Jacob-Lundstrom/lcr-meter-hardware/REV A Input Buffer Mod Board/production/bom.csv

Designator | Footprint | Quantity | Value | LCSC Part #
U1, U2 | DIP-8_W7.62mm | 2 | AMP03GPZ
U3 | DIP-8_W7.62mm | 1 | LF353N
