Jacob-Lundstrom/lcr-meter-hardware/lcr-meter/additional components/_Mechanical/c-1337445-10-3-c-3d.stp

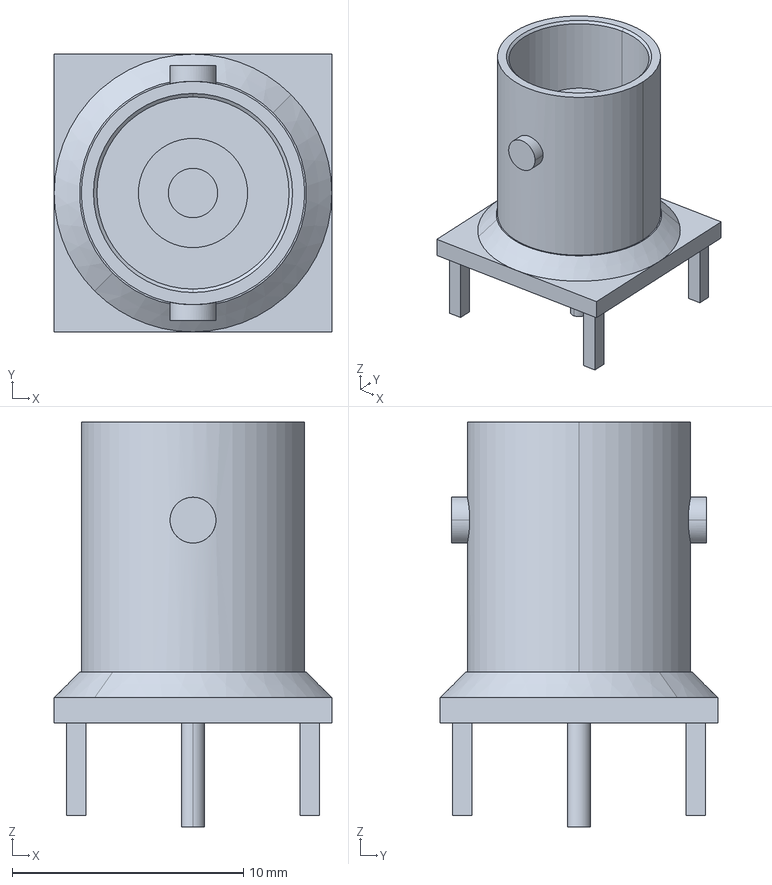
[picture p4: CAD file, 2024-11-07]
lcr-meter/additional components/_Mechanical/c-1337445-10-3-c-3d.stp
12.0 x 12.0 x 17.5 mm
