Jacob-Lundstrom/lcr-meter-hardware/lcr-meter/additional components/CG04874_8M/XTAL_CG04874_NDK.step

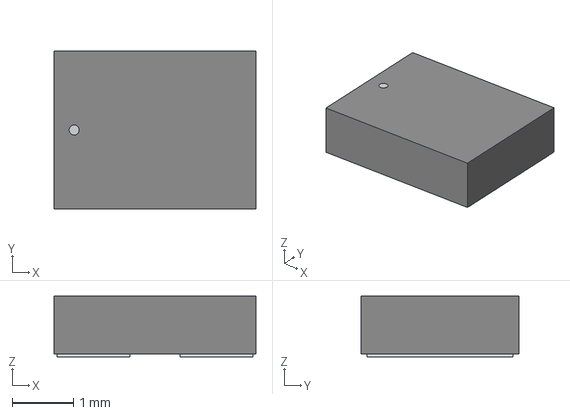
[picture p5: CAD file, 2024-10-27]
lcr-meter/additional components/CG04874_8M/XTAL_CG04874_NDK.step
3.30 x 2.59 x 0.993 mm
