Jacob-Lundstrom/lcr-meter-hardware/lcr-meter/additional components/LF353N_NOPB/LF353N.step

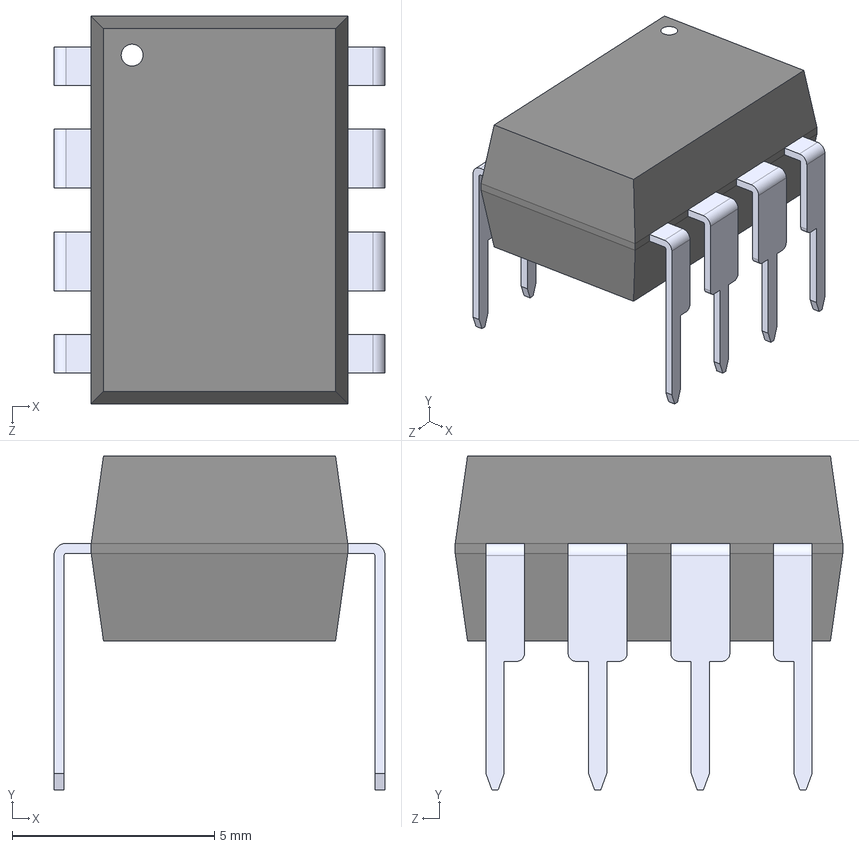
[picture p6: CAD file, 2024-10-28]
lcr-meter/additional components/LF353N_NOPB/LF353N.step
8.19 x 8.26 x 9.59 mm
