Jacob-Lundstrom/lcr-meter-hardware/lcr-meter/additional components/PA4340_332ANLT/IND_223NLT_PUL.step

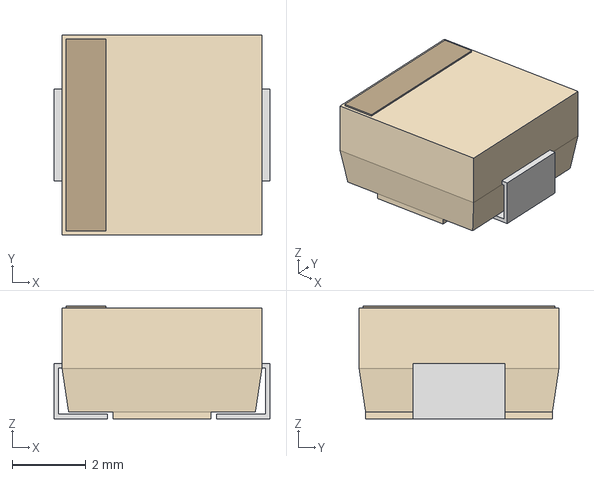
[picture p7: CAD file, 2024-10-27]
lcr-meter/additional components/PA4340_332ANLT/IND_223NLT_PUL.step
5.85 x 5.41 x 3.05 mm
