Jacob-Lundstrom/lcr-meter-hardware/REV A Input Buffer Mod Board/additional components/AMP03GPZ/N_8_ADI.step

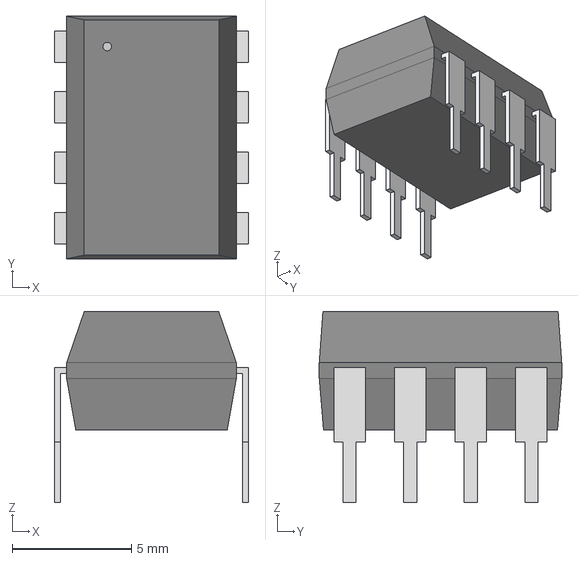
[picture p8: CAD file, 2024-10-13]
REV A Input Buffer Mod Board/additional components/AMP03GPZ/N_8_ADI.step
8.13 x 10.2 x 8.00 mm
