Jacob-Lundstrom/lcr-meter-hardware/lcr-meter/lcr-meter.pdf

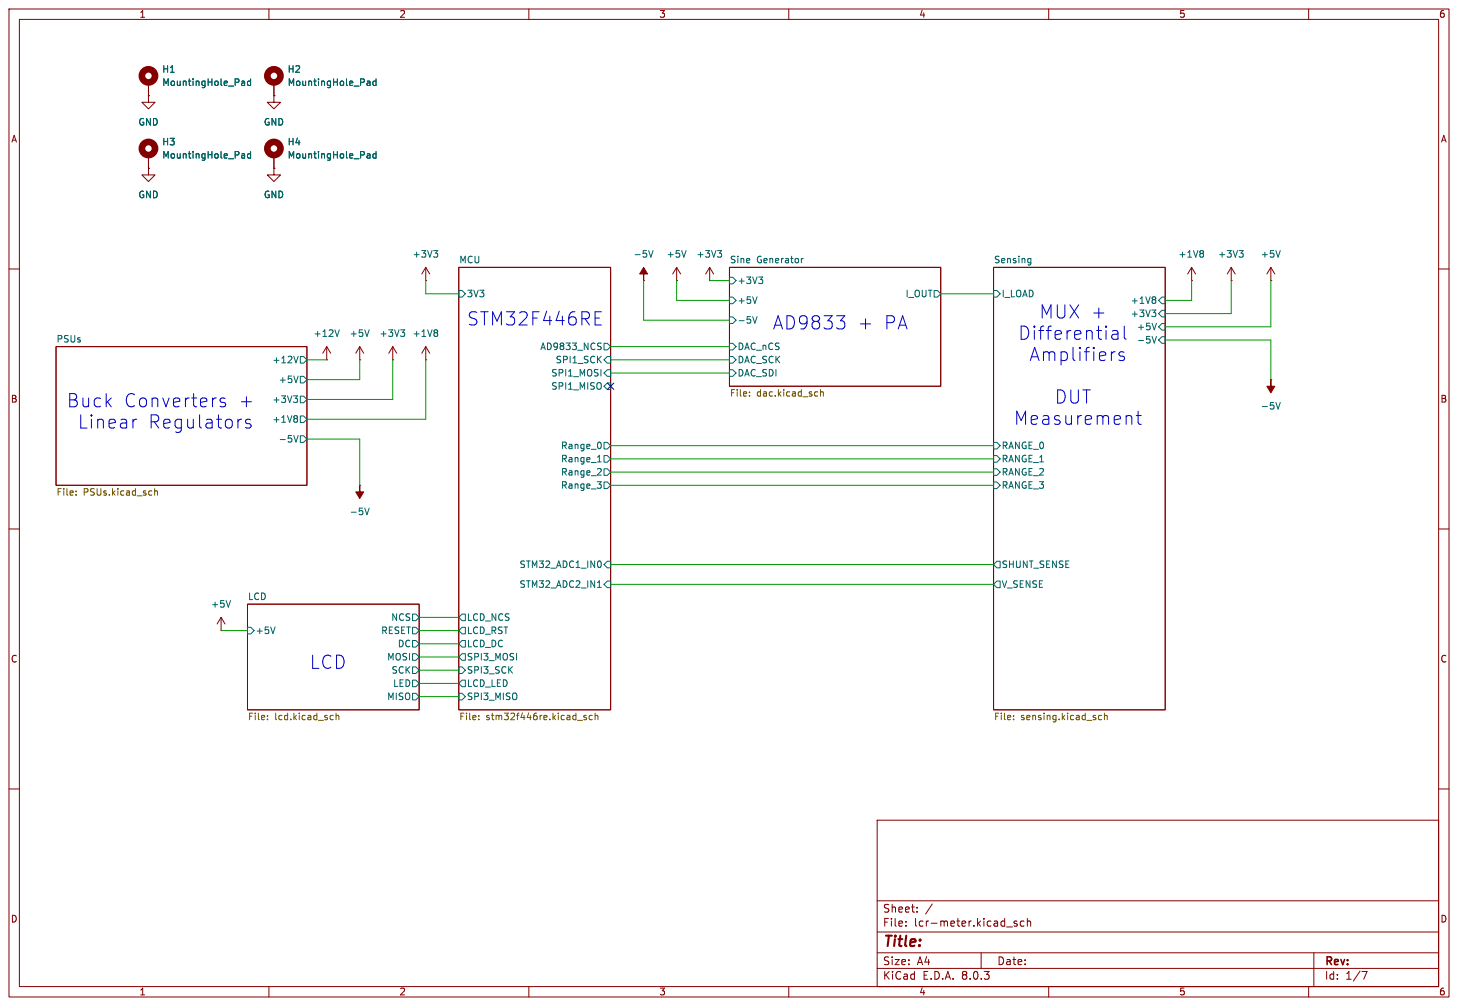
[picture p9: page 1]

NCS
File: stm32f446re.kicad_sch RESET SCK MISO

Id: 1/7 Title: File: lcr-meter.kicad_sch Sheet: /

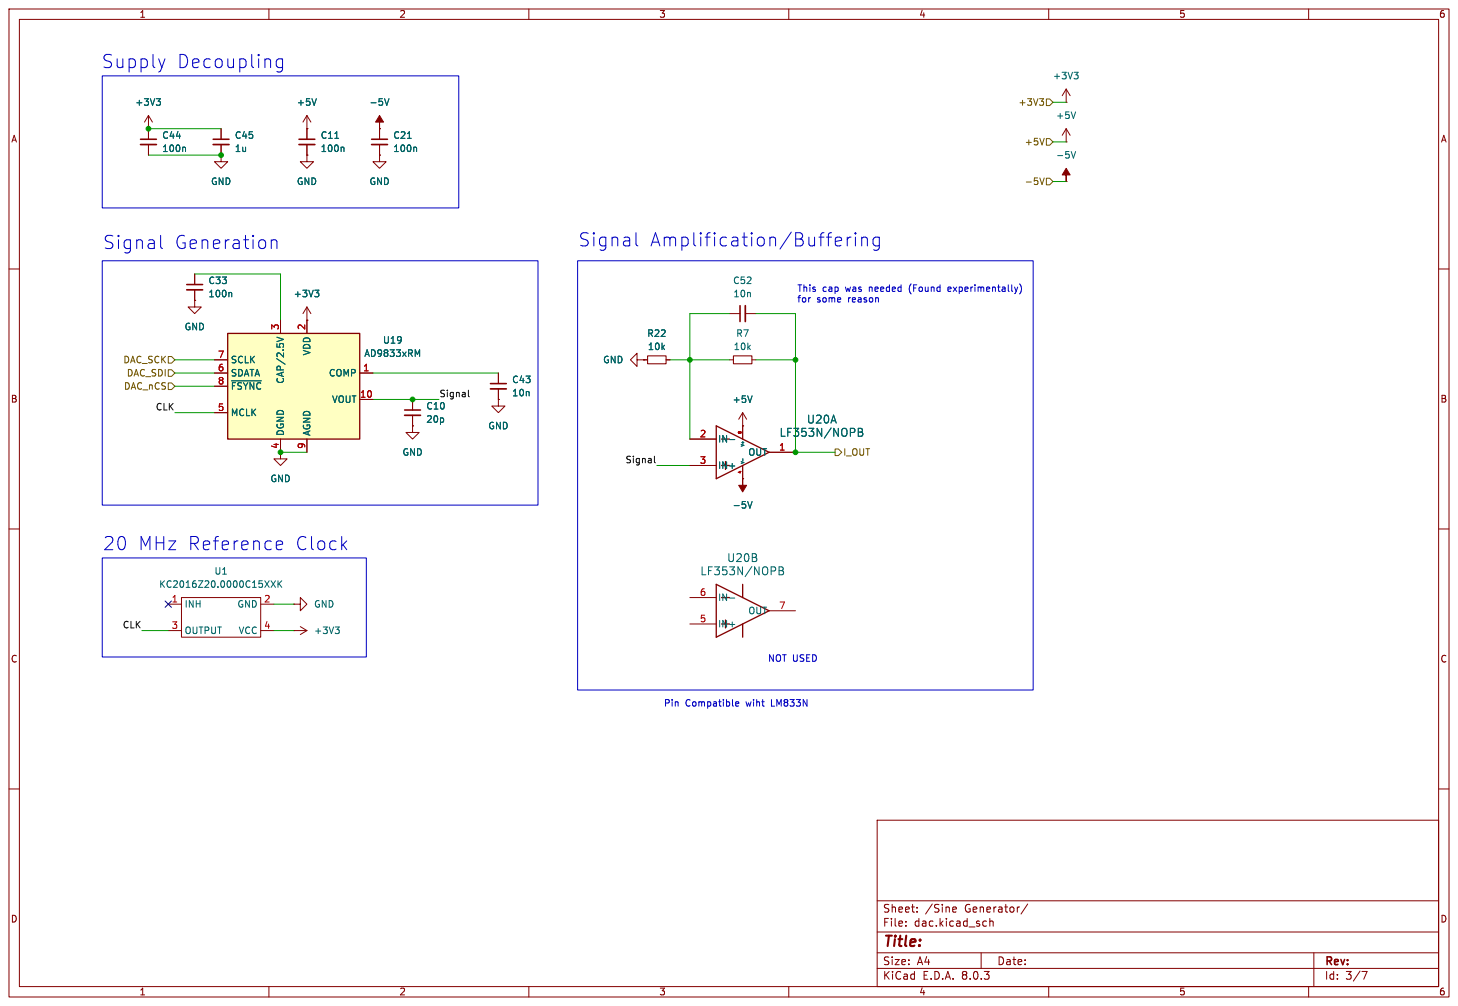
[picture p10: page 2]

This cap was needed (Found experimentally)

4 MCLK 5 SDATA 6 SCLK 7 ~{FSYNC} 8 AGND

Id: 3/7 Title: File: dac.kicad_sch Sheet: /Sine Generator/

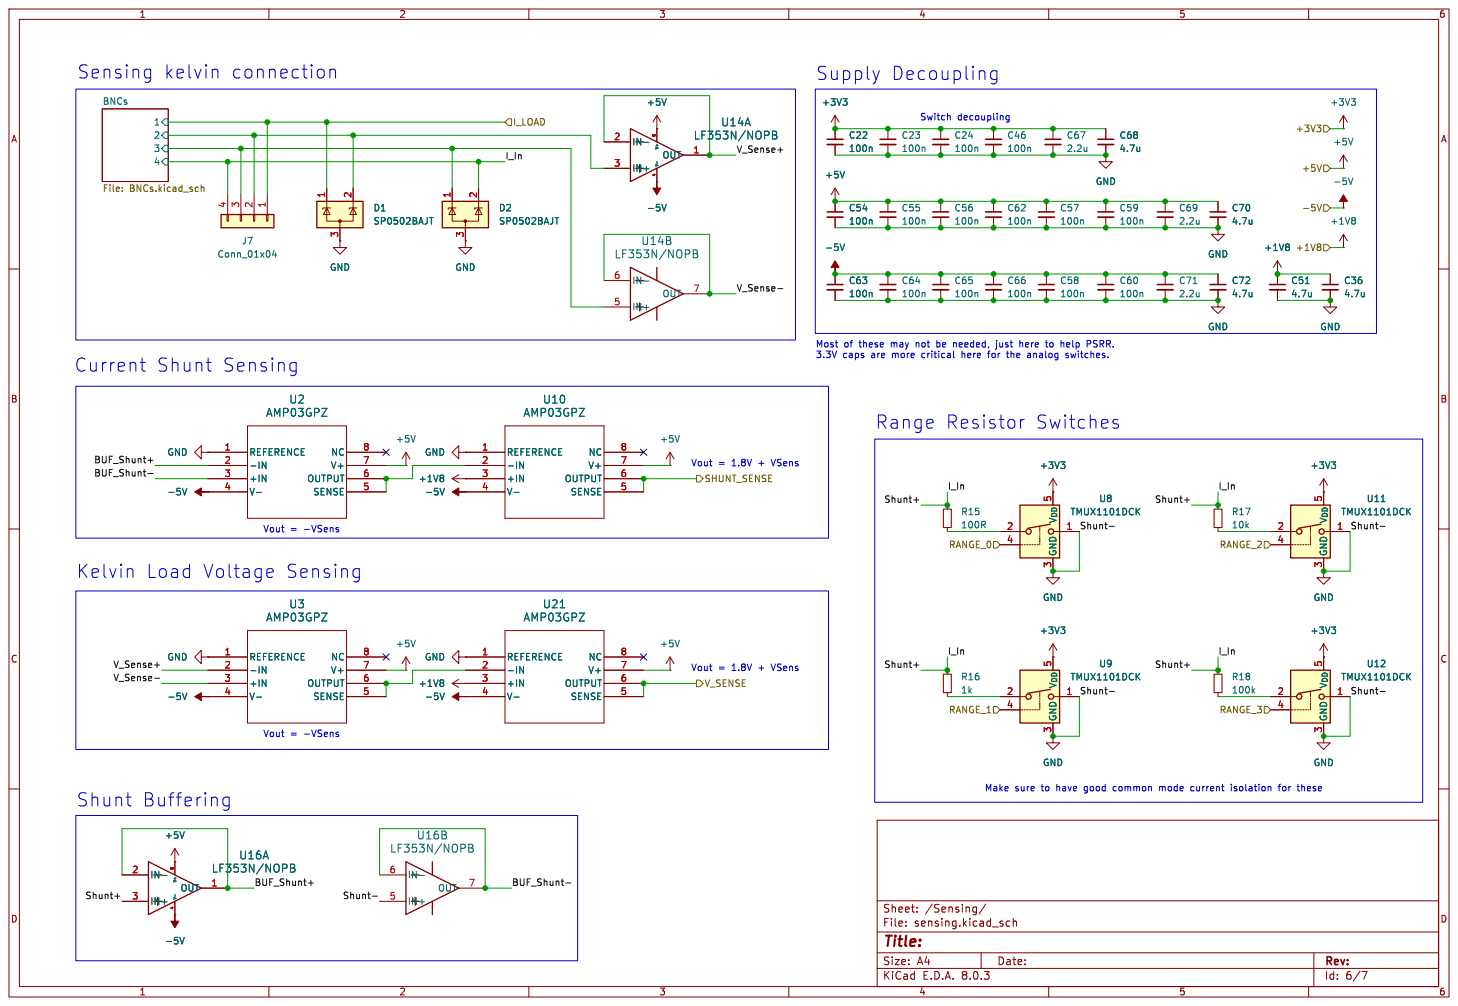
[picture p11: page 3]

Kelvin Load Voltage Sensing

Id: 6/7 Title: File: sensing.kicad_sch Sheet: /Sensing/

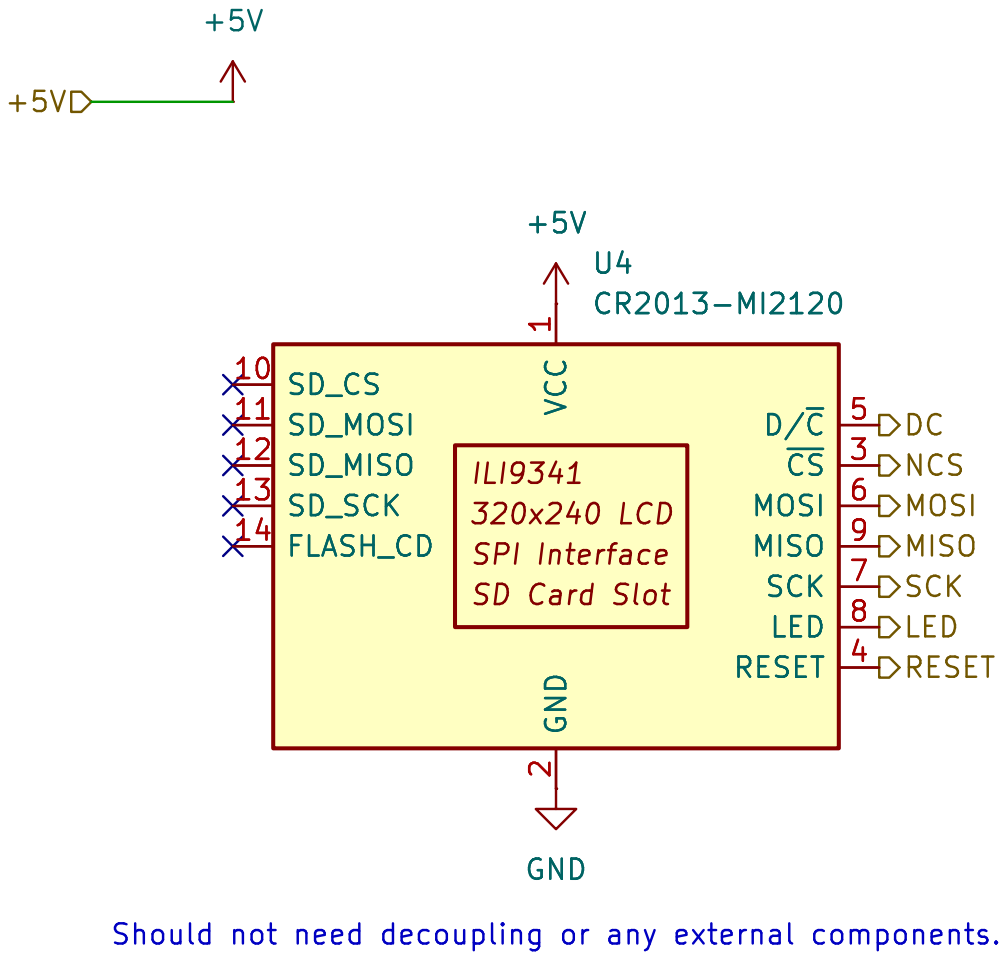
[picture p12: page 4]

ILI9341 SD Card Slot SPI Interface VCC

2 ~{CS}3 RESET 4 D/~{C}5 MOSI 6 SCK 7

Id: 7/7 Title: File: lcd.kicad_sch Sheet: /LCD/

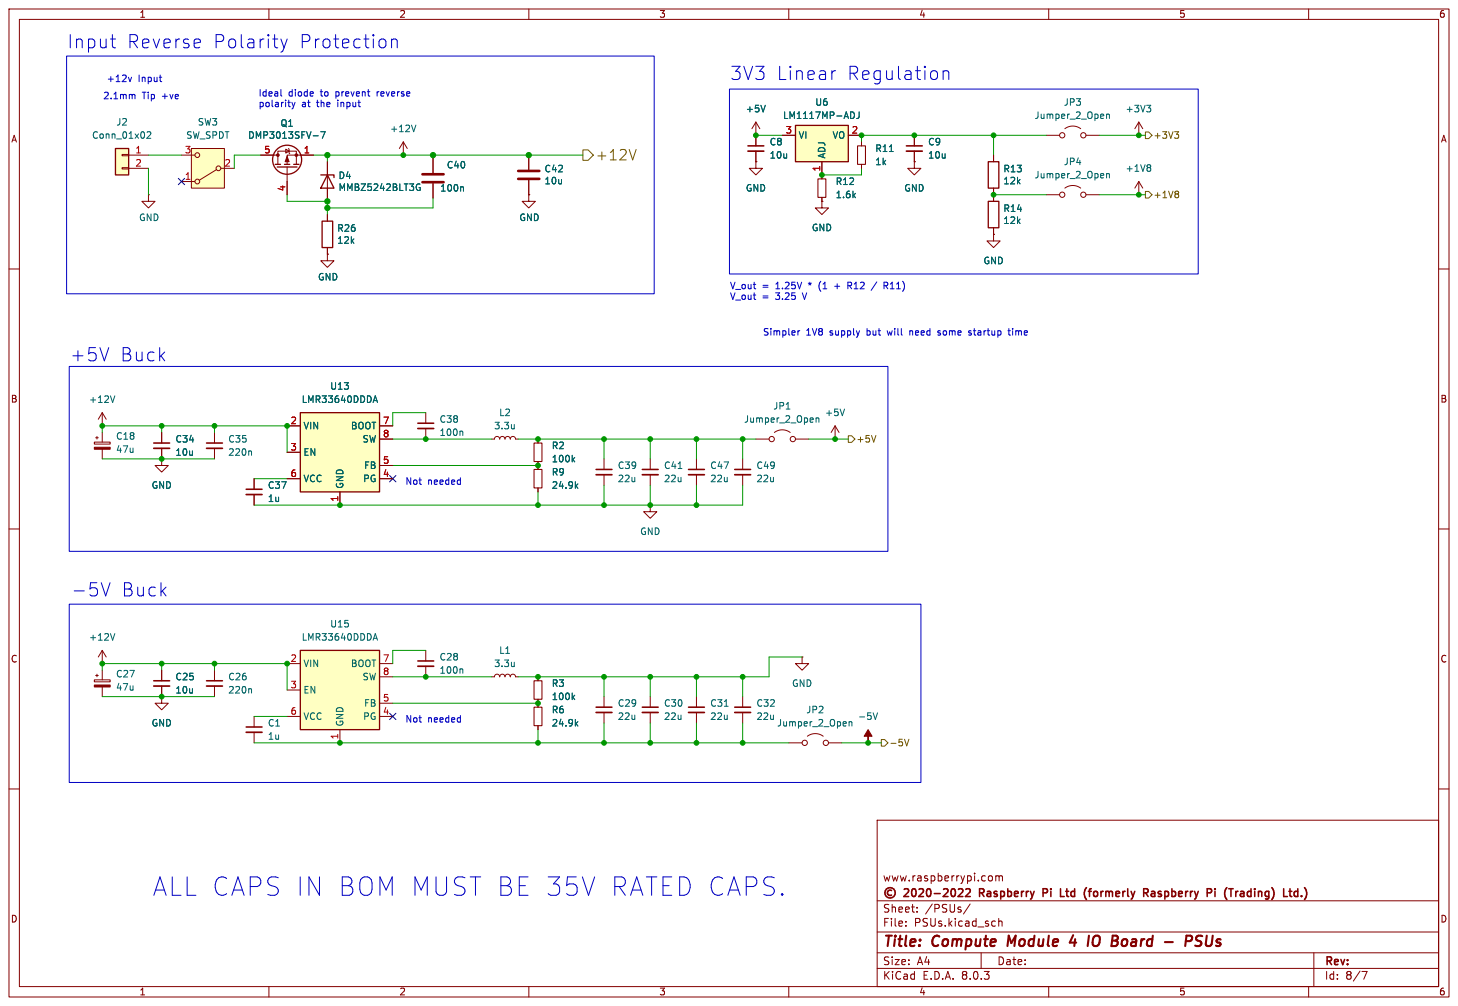
[picture p13: page 5]

2.1mm Tip +ve Input Reverse Polarity Protection

Ideal diode to prevent reverse

Simpler 1V8 supply but will need some startup time

1 VIN 2 EN 3 PG 4 FB 5 VCC 6 BOOT 7 SW 8 U13
LMR33640DDDA

1 VIN 2 EN 3 PG 4 FB 5 VCC 6 BOOT 7 SW 8 R2

Not needed Not needed ALL CAPS IN BOM MUST BE 35V RATED CAPS.
24.9k GND

1 VIN 2 EN 3 PG 4 FB 5 VCC 6 BOOT 7 SW 8 U15

Id: 8/7 Title: Compute Module 4 IO Board - PSUs

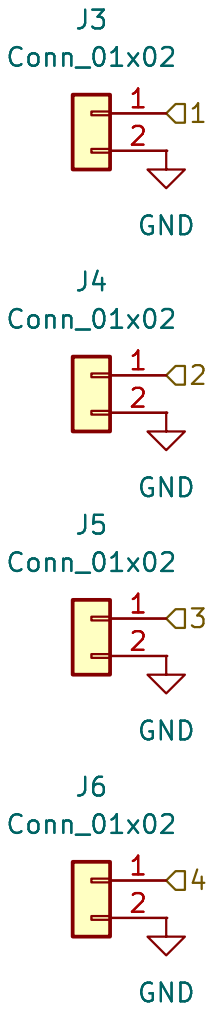
[picture p14: page 6]

Id: 8/7 Title: File: BNCs.kicad_sch Sheet: /Sensing/BNCs/

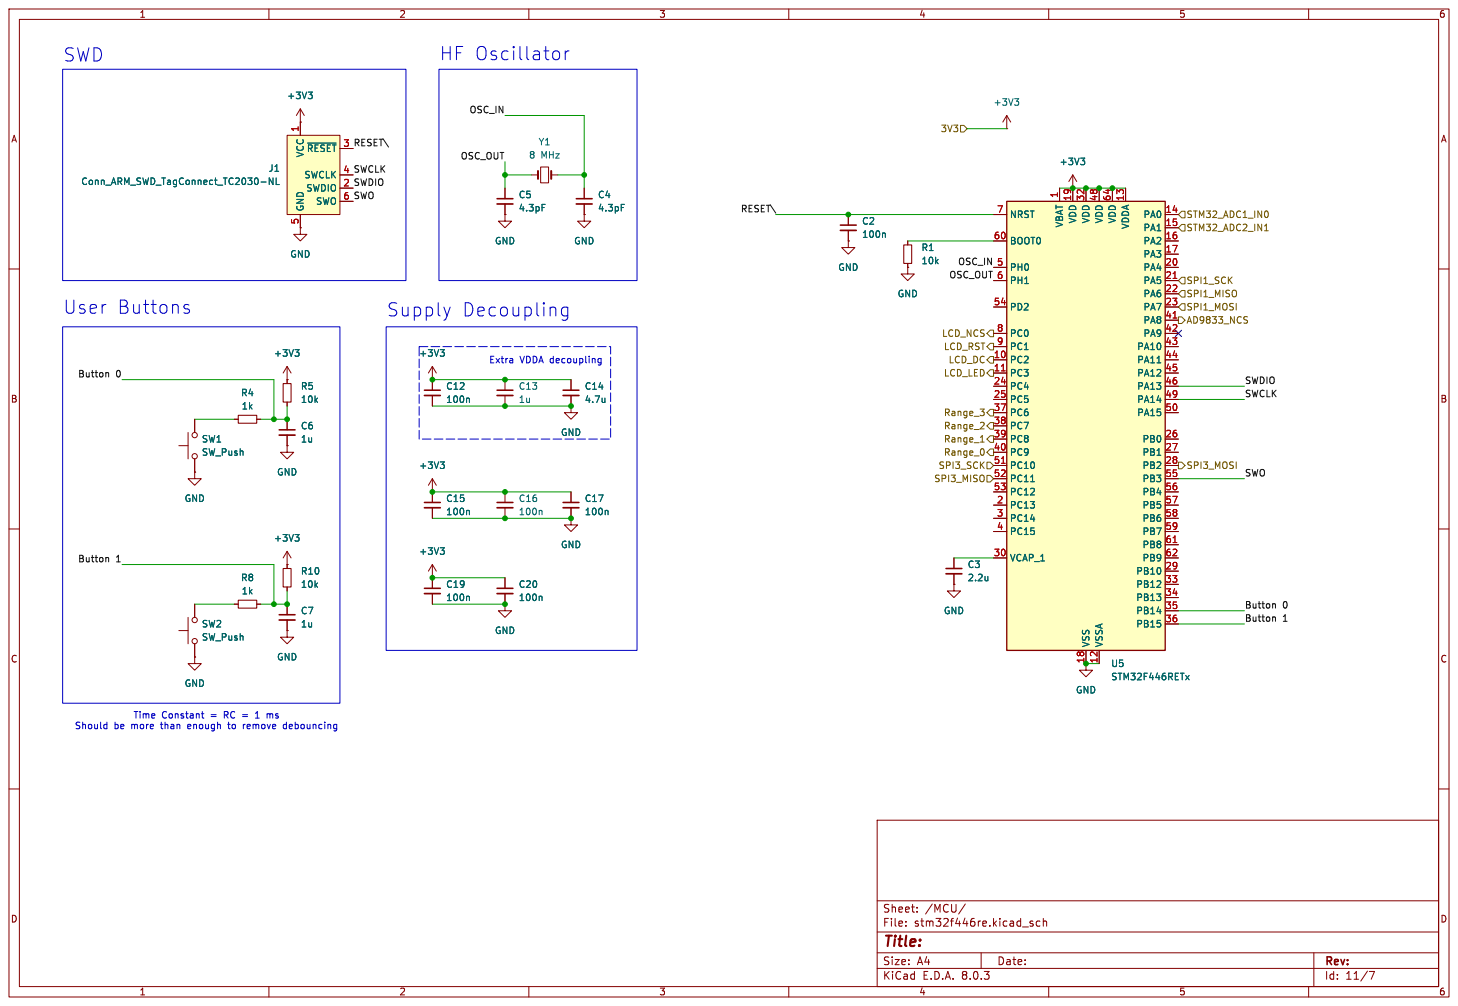
[picture p15: page 7]

1 SWDIO 2 ~{RESET}3 SWCLK 4 GND

1 PC2 10 PC3 11 VSSA 12 VDDA 13 PA0 14 PA1 15 PA2 16 PA3 17 VSS 18 VDD 19 PC13 2 PA4 20 PA5 21 PA6 22 PA7 23 PC4 24 PC5 25 PB0 26 PB1 27 PB2 28 PB10 29 PC14 3 VCAP_1 30 VDD 32 PB12 33 PB13 34 PB14 35 PB15 36 PC6 37 PC7 38 PC8 39 PC15 4 PC9 40 PA8 41 PA9 42 PA10 43 PA11 44 PA12 45 PA13 46 VDD 48 PA14 49 PH0 5 PA15 50 PC10 51 PC11 52 PC12 53 PD2 54 PB3 55 PB4 56 PB5 57 PB6 58 PB7 59 PH1 6 BOOT0 60 PB8 61 PB9 62 VDD 64 NRST 7 PC0 8 PC1 9 U5STM32F446RETx R4

1 PC2 10 PC3 11 VSSA 12 VDDA 13 PA0 14 PA1 15 PA2 16 PA3 17 VSS 18 VDD 19 PC13 2 PA4 20 PA5 21 PA6 22 PA7 23 PC4 24 PC5 25 PB0 26 PB1 27 PB2 28 PB10 29 PC14 3 VCAP_1 30 VDD 32 PB12 33 PB13 34 PB14 35 PB15 36 PC6 37 PC7 38 PC8 39 PC15 4 PC9 40 PA8 41 PA9 42 PA10 43 PA11 44 PA12 45 PA13 46 VDD 48 PA14 49 PH0 5 PA15 50 PC10 51 PC11 52 PC12 53 PD2 54 PB3 55 PB4 56 PB5 57 PB6 58 PB7 59 PH1 6 BOOT0 60 PB8 61 PB9 62 VDD 64 NRST 7 PC0 8 PC1 9 C3

Id: 11/7 Title: File: stm32f446re.kicad_sch Sheet: /MCU/
