Jacob-Lundstrom/lcr-meter-hardware/lcr-meter/lcr-meter.kicad_pcb

## KiCad design lcr-meter/lcr-meter.kicad_pcb (2024-11-10)

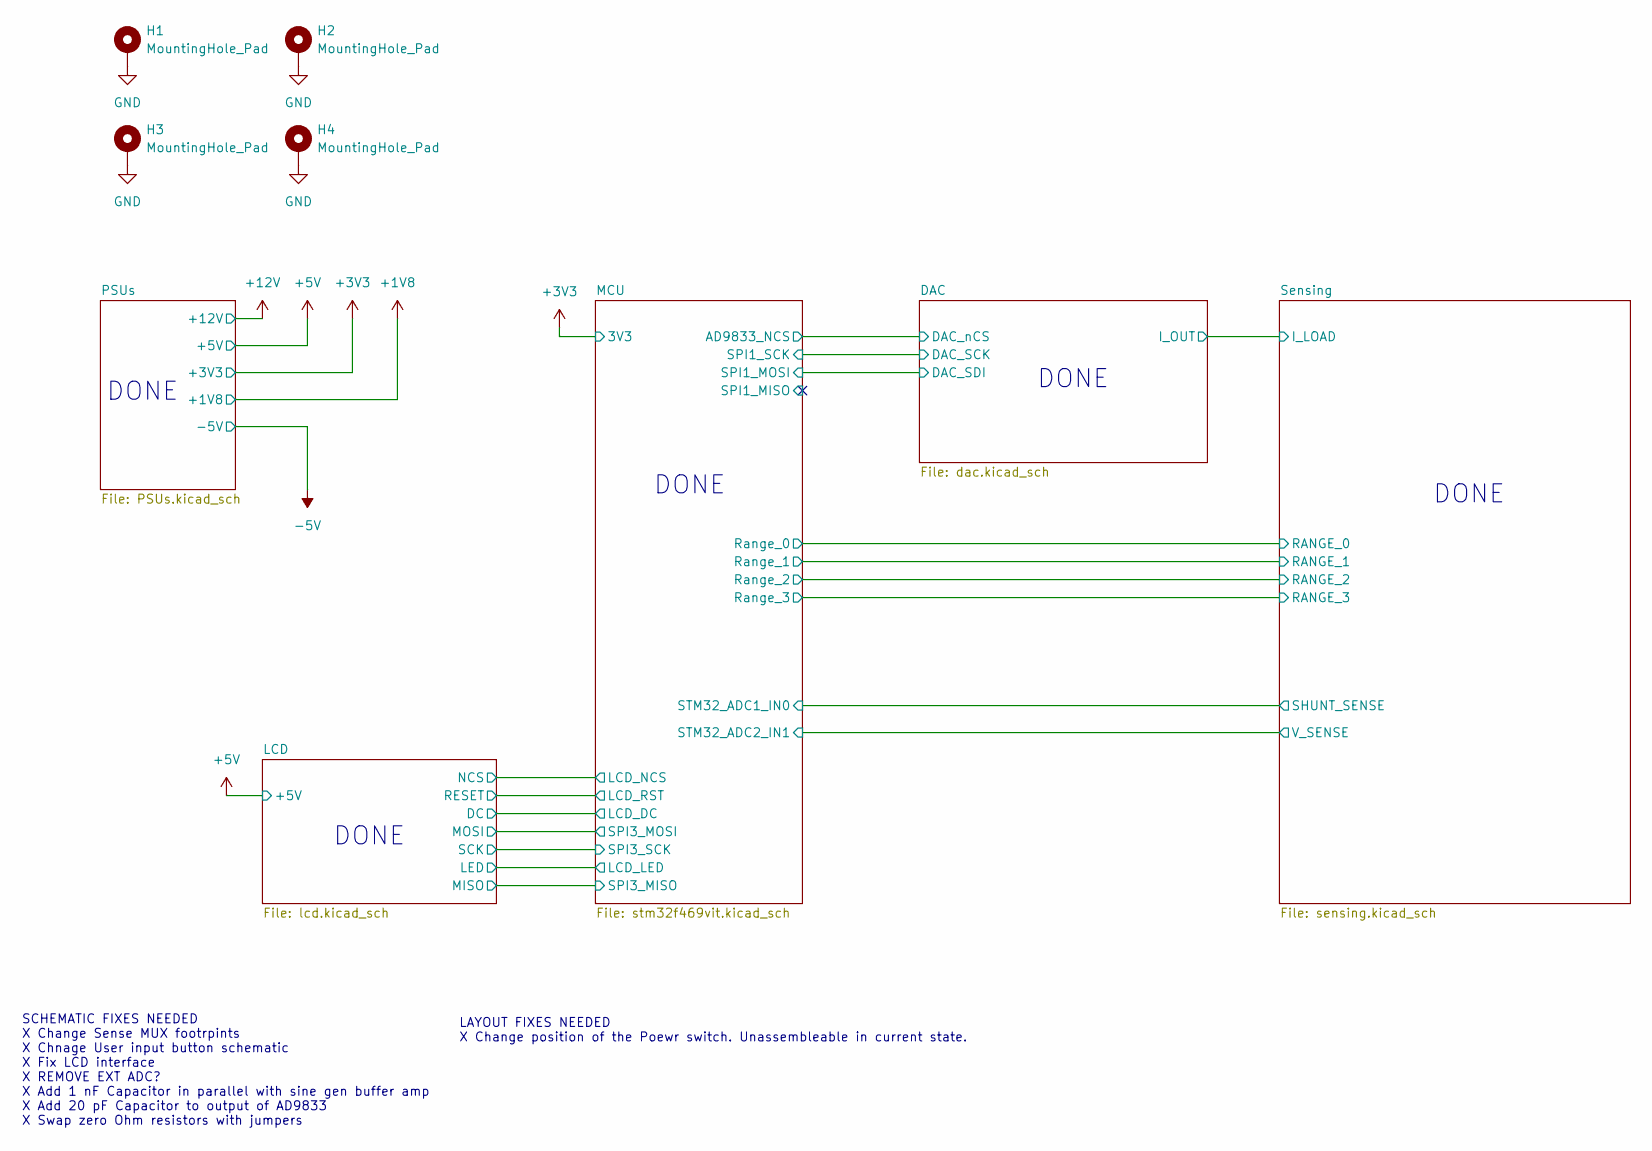
[picture p16: schematic lcr-meter.kicad_sch]

Parts:
H1, H2, H3, H4: MountingHole_Pad; MountingHole_3.2mm_M3_Pad_Via

Connections:
GND: H1.1, H2.1, H3.1, H4.1; also elsewhere on the board

Notes on the sheet:
DONE
SCHEMATIC FIXES NEEDED X Change Sense MUX footrpints X Chnage User input button schematic X Fix LCD interface X REMOVE EXT ADC? X Add 1 nF Capacitor in parallel with sine gen buffer amp X Add 20 pF Capacitor to output of AD9833 X Swap zero Ohm resistors with jumpers
LAYOUT FIXES NEEDED X Change position of the Poewr switch. Unassembleable in current state.

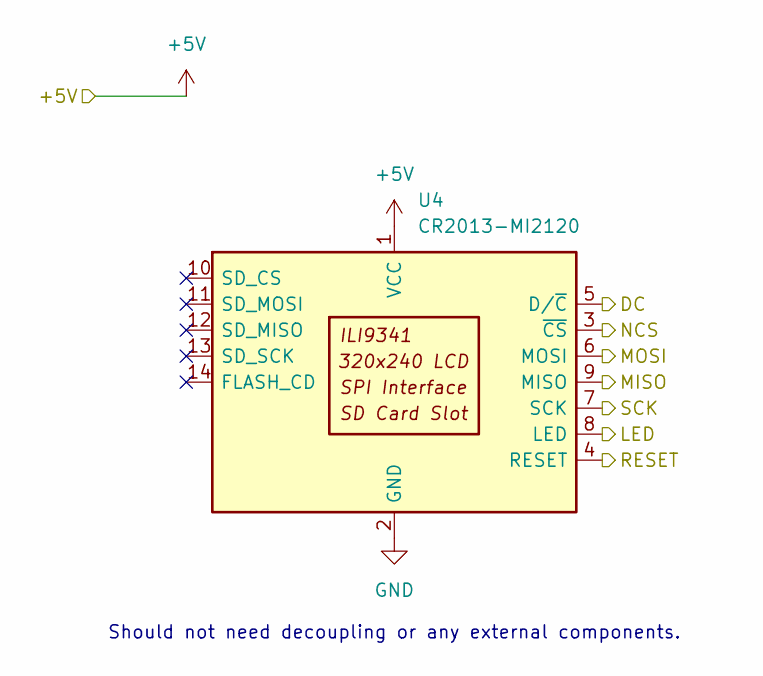
[picture p17: schematic lcd.kicad_sch]

Parts:
U4: CR2013-MI2120

Connections:
+5V: U4.1 (VCC); also elsewhere on the board
/LCD/DC: U4.5 (D/~C); also elsewhere on the board
/LCD/LED: U4.8 (LED); also elsewhere on the board
/LCD/MISO: U4.9 (MISO); also elsewhere on the board
/LCD/MOSI: U4.6 (MOSI); also elsewhere on the board
/LCD/NCS: U4.3 (~CS); also elsewhere on the board
/LCD/RESET: U4.4 (RESET); also elsewhere on the board
/LCD/SCK: U4.7 (SCK); also elsewhere on the board
GND: U4.2 (GND); also elsewhere on the board

Notes on the sheet:
Should not need decoupling or any external components.

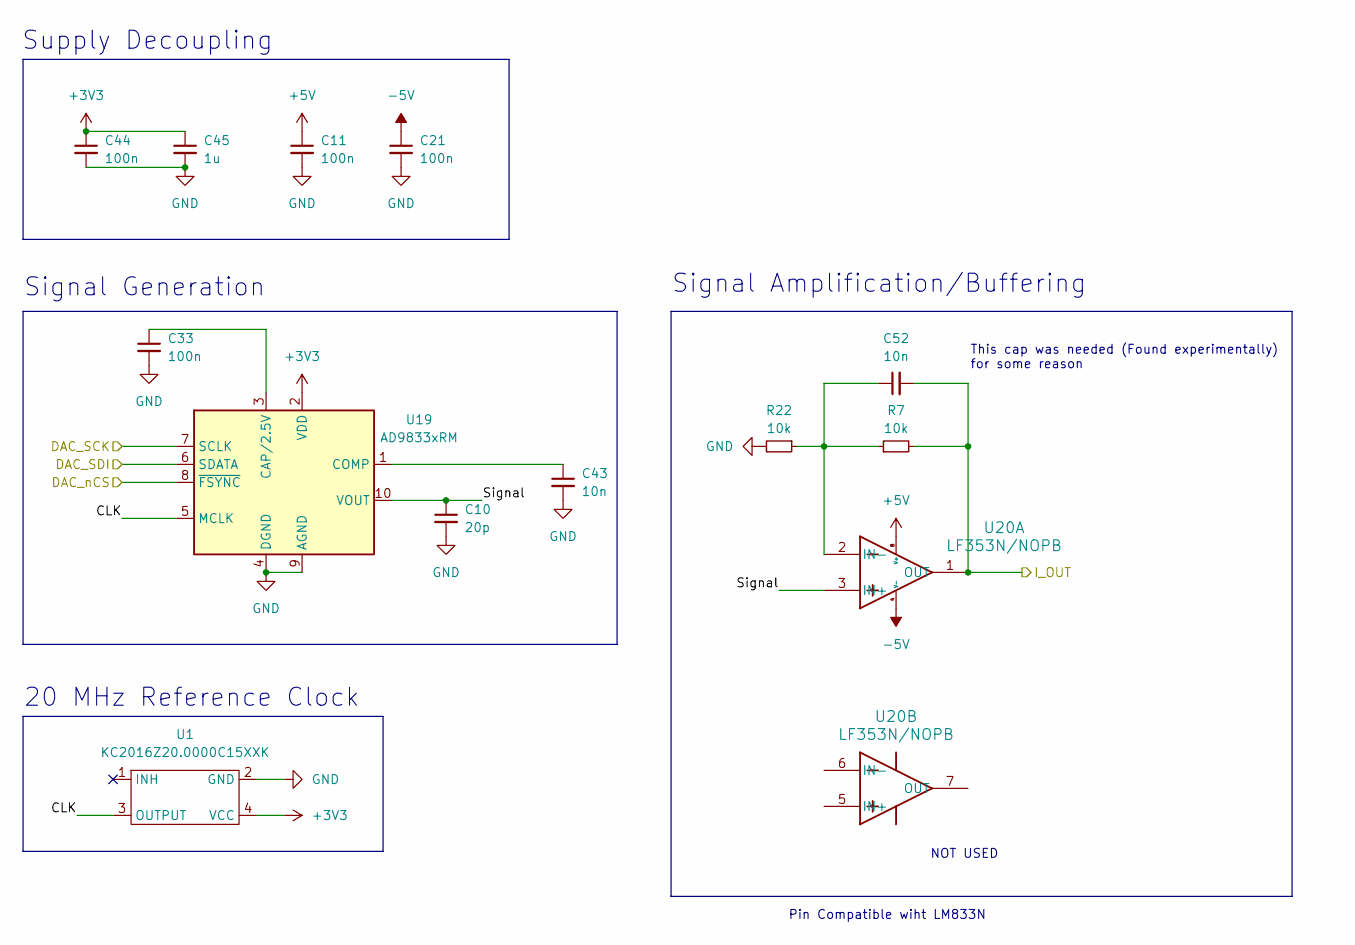
[picture p18: schematic dac.kicad_sch]

Parts:
C10: 20p; C_0402_1005Metric
C11, C21, C33, C44: 100n; C_0402_1005Metric
C43, C52: 10n; C_0402_1005Metric
C45: 1u; C_0402_1005Metric
R7, R22: 10k; R_0402_1005Metric
U1: KC2016Z20.0000C15XXK; Crystal_SMD_2016-4Pin_2.0x1.6mm
U19: AD9833xRM; MSOP-10_3x3mm_P0.5mm
U20: LF353N/NOPB; DIP-8_W7.62mm

Connections:
+3V3: C44.1, C45.1, U1.4 (VCC), U19.2 (VDD); also elsewhere on the board
+5V: C11.1, U20.8 (V+); also elsewhere on the board
-5V: C21.1, U20.4 (V-); also elsewhere on the board
/DAC/CLK: U1.3 (OUTPUT), U19.5 (MCLK)
/DAC/DAC_SCK: U19.7 (SCLK); also elsewhere on the board
/DAC/DAC_SDI: U19.6 (SDATA); also elsewhere on the board
/DAC/DAC_nCS: U19.8 (~FSYNC); also elsewhere on the board
/DAC/I_OUT: C52.2, R7.2, U20.1 (OUT); also elsewhere on the board
/DAC/Signal: C10.1, U19.10 (VOUT), U20.3 (IN+)
GND: C10.2, C11.2, C21.2, C33.2, C43.2, C44.2, C45.2, R22.2, U1.2 (GND), U19.4 (DGND), U19.9 (AGND); also elsewhere on the board
unnamed: C33.1, U19.3 (CAP/2.5V)
unnamed: C43.1, U19.1 (COMP)
unnamed: C52.1, R7.1, R22.1, U20.2 (IN-)

Notes on the sheet:
Pin Compatible wiht LM833N
20 MHz Reference Clock
This cap was needed (Found experimentally) for some reason
Supply Decoupling
Signal Generation
NOT USED
Signal Amplification/Buffering

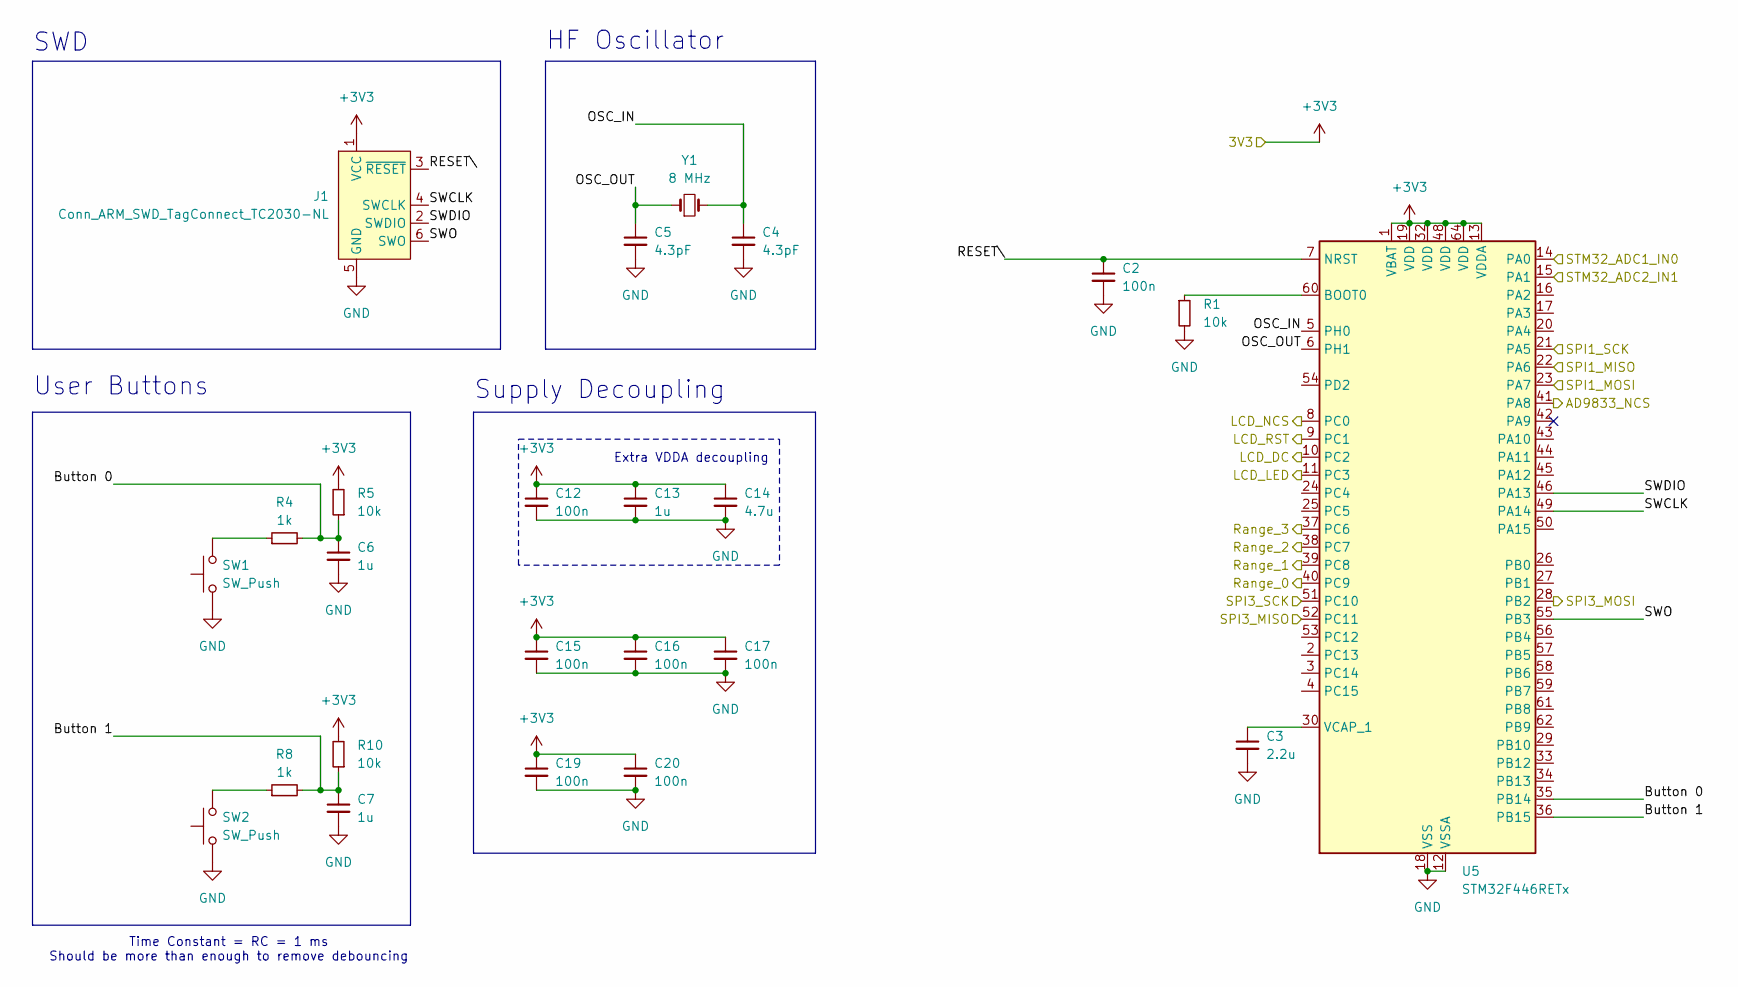
[picture p19: schematic stm32f469vit.kicad_sch]

Parts:
C2, C12, C15, C16, C17, C19, C20: 100n; C_0402_1005Metric
C3: 2.2u; C_0402_1005Metric
C4, C5: 4.3pF; C_0402_1005Metric
C6, C7, C13: 1u; C_0402_1005Metric
C14: 4.7u; C_0805_2012Metric
J1: Conn_ARM_SWD_TagConnect_TC2030-NL; Tag-Connect_TC2030-IDC-NL_2x03_P1.27mm_Vertical
R1, R5, R10: 10k; R_0402_1005Metric
R4, R8: 1k; R_0402_1005Metric
SW1, SW2: SW_Push; SW_PUSH_6mm_H5mm
U5: STM32F446RETx; LQFP-64_10x10mm_P0.5mm
Y1: 8 MHz; XTAL_CG04874_NDK-L

Connections:
+3V3: C12.1, C13.1, C14.1, C15.1, C16.1, C17.1, C19.1, C20.1, J1.1 (VCC), R5.2, R10.2, U5.1 (VBAT), U5.13 (VDDA), U5.19 (VDD), U5.32 (VDD), U5.48 (VDD), U5.64 (VDD); also elsewhere on the board
/DAC/DAC_SCK: U5.21 (PA5); also elsewhere on the board
/DAC/DAC_SDI: U5.23 (PA7); also elsewhere on the board
/DAC/DAC_nCS: U5.41 (PA8); also elsewhere on the board
/LCD/DC: U5.10 (PC2); also elsewhere on the board
/LCD/LED: U5.11 (PC3); also elsewhere on the board
/LCD/MISO: U5.52 (PC11); also elsewhere on the board
/LCD/MOSI: U5.28 (PB2); also elsewhere on the board
/LCD/NCS: U5.8 (PC0); also elsewhere on the board
/LCD/RESET: U5.9 (PC1); also elsewhere on the board
/LCD/SCK: U5.51 (PC10); also elsewhere on the board
/MCU/Button 0: C6.1, R4.2, R5.1, U5.35 (PB14)
/MCU/Button 1: C7.1, R8.2, R10.1, U5.36 (PB15)
/MCU/OSC_IN: C4.1, U5.5 (PH0), Y1.2
/MCU/OSC_OUT: C5.1, U5.6 (PH1), Y1.1
/MCU/RESET\: C2.1, J1.3 (~RESET), U5.7 (NRST)
/MCU/Range_0: U5.40 (PC9); also elsewhere on the board
/MCU/Range_1: U5.39 (PC8); also elsewhere on the board
/MCU/Range_2: U5.38 (PC7); also elsewhere on the board
/MCU/Range_3: U5.37 (PC6); also elsewhere on the board
/MCU/SPI1_MISO: U5.22 (PA6)
/MCU/STM32_ADC1_IN0: U5.14 (PA0); also elsewhere on the board
/MCU/STM32_ADC2_IN1: U5.15 (PA1); also elsewhere on the board
/MCU/SWCLK: J1.4 (SWCLK), U5.49 (PA14)
/MCU/SWDIO: J1.2 (SWDIO), U5.46 (PA13)
/MCU/SWO: J1.6 (SWO), U5.55 (PB3)
GND: C2.2, C3.2, C4.2, C5.2, C6.2, C7.2, C12.2, C13.2, C14.2, C15.2, C16.2, C17.2, C19.2, C20.2, J1.5 (GND), R1.2, SW1.1, SW2.1, U5.12 (VSSA), U5.18 (VSS), U5.31 (VSS), U5.47 (VSS), U5.63 (VSS); also elsewhere on the board
unnamed: R4.1, SW1.2
unnamed: R8.1, SW2.2
unnamed: R1.1, U5.60 (BOOT0)
unnamed: C3.1, U5.30 (VCAP_1)

Notes on the sheet:
Extra VDDA decoupling
Supply Decoupling
SWD
HF Oscillator
User Buttons
Time Constant = RC = 1 ms Should be more than enough to remove debouncing

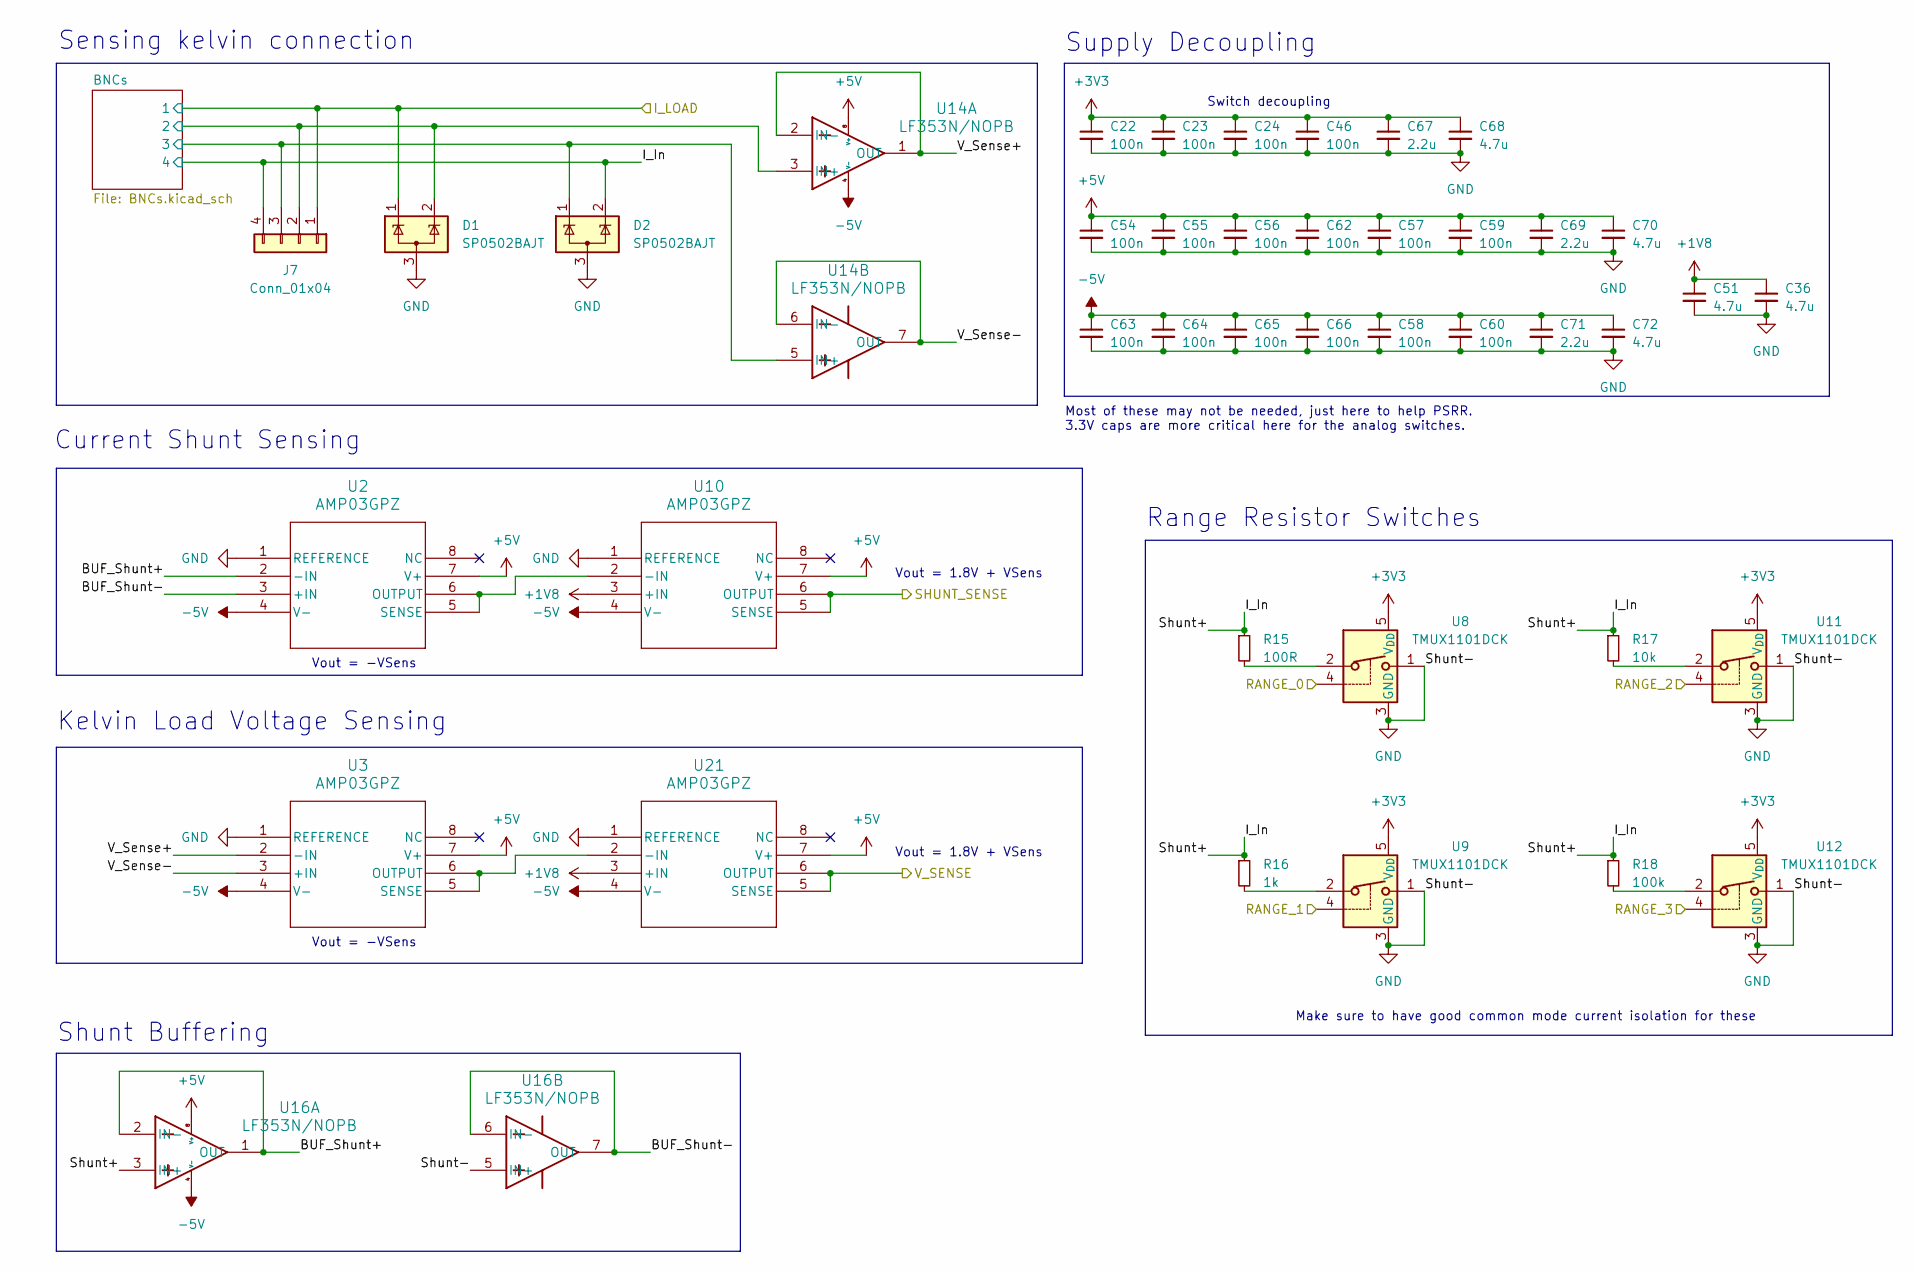
[picture p20: schematic sensing.kicad_sch]

Parts:
C22, C23, C24, C46, C54, C55, C56, C57, C58, C59, C60, C62, C63, C64, C65, C66: 100n; C_0402_1005Metric
C36, C51, C68, C70, C72: 4.7u; C_0805_2012Metric
C67, C69, C71: 2.2u; C_0402_1005Metric
D1, D2: SP0502BAJT; SOT-323_SC-70
J7: Conn_01x04; PinHeader_1x04_P2.54mm_Vertical
R15: 100R; R_0402_1005Metric
R16: 1k; R_0402_1005Metric
R17: 10k; R_0402_1005Metric
R18: 100k; R_0402_1005Metric
U2, U3, U10, U21: AMP03GPZ; N_8_ADI
U8, U9, U11, U12: TMUX1101DCK; SOT-353_SC-70-5
U14, U16: LF353N/NOPB; DIP-8_W7.62mm

Connections:
+1V8: C36.1, C51.1, U10.3 (+IN), U21.3 (+IN); also elsewhere on the board
+3V3: C22.1, C23.1, C24.1, C46.1, C67.1, C68.1, U8.5 (V_{DD}), U9.5 (V_{DD}), U11.5 (V_{DD}), U12.5 (V_{DD}); also elsewhere on the board
+5V: C54.1, C55.1, C56.1, C57.1, C59.1, C62.1, C69.1, C70.1, U2.7 (V+), U3.7 (V+), U10.7 (V+), U14.8 (V+), U16.8 (V+), U21.7 (V+); also elsewhere on the board
-5V: C58.1, C60.1, C63.1, C64.1, C65.1, C66.1, C71.1, C72.1, U2.4 (V-), U3.4 (V-), U10.4 (V-), U14.4 (V-), U16.4 (V-), U21.4 (V-); also elsewhere on the board
/DAC/I_OUT: D1.1 (K), J7.1; also elsewhere on the board
/MCU/Range_0: U8.4; also elsewhere on the board
/MCU/Range_1: U9.4; also elsewhere on the board
/MCU/Range_2: U11.4; also elsewhere on the board
/MCU/Range_3: U12.4; also elsewhere on the board
/MCU/STM32_ADC1_IN0: U10.5 (SENSE), U10.6 (OUTPUT); also elsewhere on the board
/MCU/STM32_ADC2_IN1: U21.5 (SENSE), U21.6 (OUTPUT); also elsewhere on the board
/Sensing/BNCs/2: D1.2 (K), J7.2, U14.3 (IN+); also elsewhere on the board
/Sensing/BNCs/3: D2.1 (K), J7.3, U14.5 (IN+); also elsewhere on the board
/Sensing/BUF_Shunt+: U2.2 (-IN), U16.1 (OUT), U16.2 (IN-)
/Sensing/BUF_Shunt-: U2.3 (+IN), U16.6 (IN-), U16.7 (OUT)
/Sensing/I_In: D2.2 (K), J7.4, R15.1, R16.1, R17.1, R18.1, U16.3 (IN+); also elsewhere on the board
/Sensing/V_Sense+: U3.2 (-IN), U14.1 (OUT), U14.2 (IN-)
/Sensing/V_Sense-: U3.3 (+IN), U14.6 (IN-), U14.7 (OUT)
GND: C22.2, C23.2, C24.2, C36.2, C46.2, C51.2, C54.2, C55.2, C56.2, C57.2, C58.2, C59.2, C60.2, C62.2, C63.2, C64.2, C65.2, C66.2, C67.2, C68.2, C69.2, C70.2, C71.2, C72.2, D1.3 (A), D2.3 (A), U2.1 (REFERENCE), U3.1 (REFERENCE), U8.1, U8.3 (GND), U9.1, U9.3 (GND), U10.1 (REFERENCE), U11.1, U11.3 (GND), U12.1, U12.3 (GND), U16.5 (IN+), U21.1 (REFERENCE); also elsewhere on the board
unnamed: R15.2, U8.2
unnamed: R16.2, U9.2
unnamed: R17.2, U11.2
unnamed: R18.2, U12.2
unnamed: U2.5 (SENSE), U2.6 (OUTPUT), U10.2 (-IN)
unnamed: U3.5 (SENSE), U3.6 (OUTPUT), U21.2 (-IN)

Notes on the sheet:
Make sure to have good common mode current isolation for these
Sensing kelvin connection
Vout = 1.8V + VSens
Vout = -VSens
Shunt Buffering
Current Shunt Sensing
Most of these may not be needed, just here to help PSRR. 3.3V caps are more critical here for the analog switches.
Range Resistor Switches
Supply Decoupling
Kelvin Load Voltage Sensing
Switch decoupling

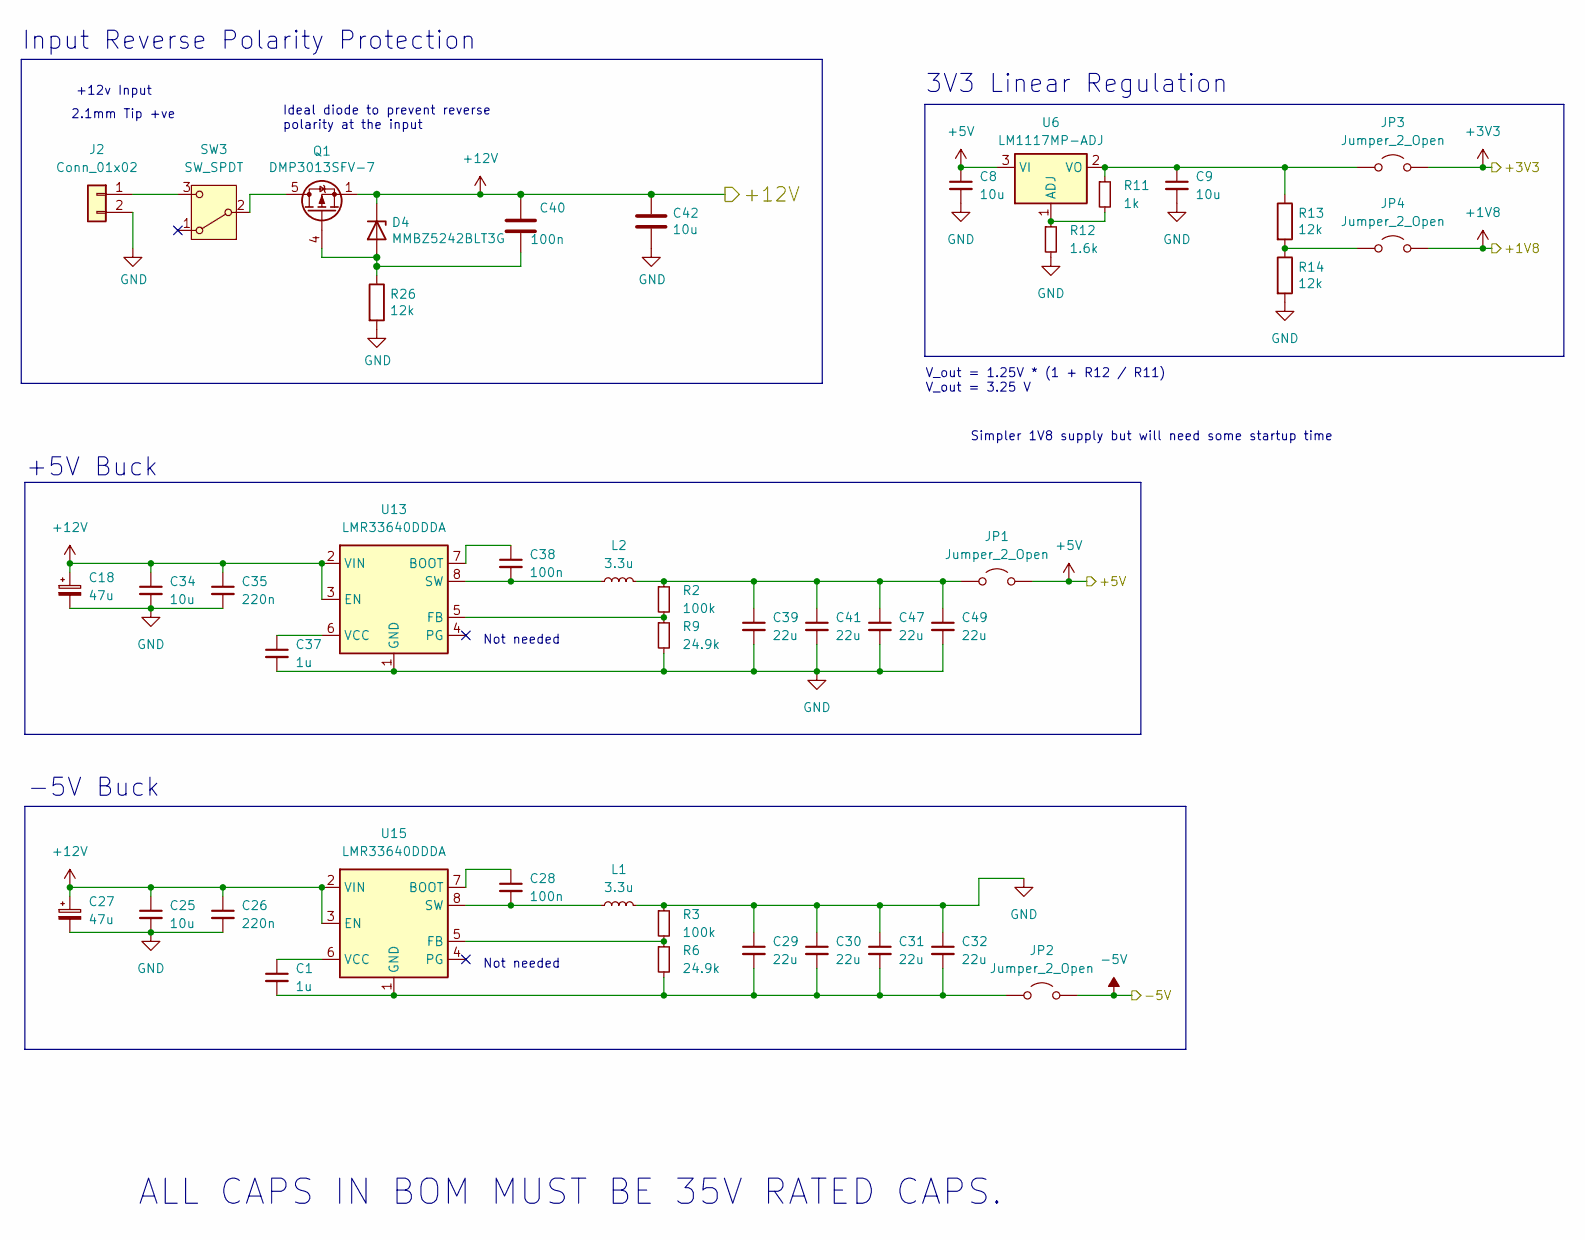
[picture p21: schematic PSUs.kicad_sch, Compute Module 4 IO Board - PSUs]

Parts:
C1, C37: 1u; C_0402_1005Metric
C8, C9, C25, C34: 10u; C_0805_2012Metric
C18, C27: 47u; CP_Elec_6.3x7.7
C26, C35: 220n; C_0402_1005Metric
C28, C38: 100n; C_0402_1005Metric
C29, C30, C31, C32, C39, C41, C47, C49: 22u; C_0805_2012Metric
C40: 100n; C_0402_1005Metric; Part Description 0.1uF 10% 16V Ceramic Capacitor X7R 040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
C42: 10u; C_0805_2012Metric; Part Description 10uF 10% or 20% 35V Ceramic Capacitor X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
D4: MMBZ5242BLT3G; SOT-23; Part Description Zener Diode 12V 225mW 5% Surface Mount 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
J2: Conn_01x02; PinHeader_1x02_P2.54mm_Vertical
JP1, JP2, JP3, JP4: Jumper_2_Open; SolderJumper-2_P1.3mm_Open_TrianglePad1.0x1.5mm
L1, L2: 3.3u; IND_223NLT_PUL
Q1: DMP3013SFV-7; Diodes_PowerDI3333-8; Part Description DMP3013SFV-7 - Power MOSFET, P Channel,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
R2, R3: 100k; R_0402_1005Metric
R6, R9: 24.9k; R_0402_1005Metric
R11: 1k; R_0402_1005Metric
R12: 1.6k; R_0402_1005Metric
R13, R14, R26: 12k; R_0402_1005Metric; Part Description Resistor 12K M1005 1% 63mW
SW3: SW_SPDT; SW_E-Switch_EG1224_SPDT_Angled
U6: LM1117MP-ADJ; SOT-223-3_TabPin2
U13, U15: LMR33640DDDA; Texas_HSOP-8-1EP_3.9x4.9mm_P1.27mm_ThermalVias

Connections:
+1V8: JP4.2 (B); also elsewhere on the board
+3V3: JP3.2 (B); also elsewhere on the board
+5V: C8.1, JP1.2 (B), U6.3 (VI); also elsewhere on the board
+12V: C18.1, C25.1, C26.1, C27.1, C34.1, C35.1, C40.1, C42.1, D4.3 (K), Q1.1 (S), Q1.2 (S), Q1.3 (S), U13.2 (VIN), U13.3 (EN), U15.2 (VIN), U15.3 (EN)
-5V: JP2.2 (B); also elsewhere on the board
GND: C8.2, C9.2, C18.2, C25.2, C26.2, C27.2, C29.1, C30.1, C31.1, C32.1, C34.2, C35.2, C37.2, C39.2, C41.2, C42.2, C47.2, C49.2, J2.2, L1.2, R3.1, R9.2, R12.2, R14.2, R26.2, U13.1 (GND), U13.9 (GND); also elsewhere on the board
unnamed: C40.2, D4.1 (A), Q1.4 (G), R26.1
unnamed: J2.1, SW3.3 (C)
unnamed: C39.1, C41.1, C47.1, C49.1, JP1.1 (A), L2.2, R2.1
unnamed: C1.2, C29.2, C30.2, C31.2, C32.2, JP2.1 (A), R6.2, U15.1 (GND), U15.9 (GND)
unnamed: C9.1, JP3.1 (A), R11.1, R13.1, U6.2 (VO)
unnamed: JP4.1 (A), R13.2, R14.1
unnamed: Q1.5 (D), SW3.2 (B)
unnamed: R11.2, R12.1, U6.1 (ADJ)
unnamed: C38.1, U13.7 (BOOT)
unnamed: R2.2, R9.1, U13.5 (FB)
unnamed: C38.2, L2.1, U13.8 (SW)
unnamed: C37.1, U13.6 (VCC)
unnamed: C28.1, U15.7 (BOOT)
unnamed: R3.2, R6.1, U15.5 (FB)
unnamed: C28.2, L1.1, U15.8 (SW)
unnamed: C1.1, U15.6 (VCC)

Notes on the sheet:
Not needed
Input Reverse Polarity Protection
V_out = 1.25V * (1 + R12 / R11) V_out = 3.25 V
+12v Input
-5V Buck
+5V Buck
3V3 Linear Regulation
2.1mm Tip +ve
ALL CAPS IN BOM MUST BE 35V RATED CAPS.
Simpler 1V8 supply but will need some startup time
Ideal diode to prevent reverse polarity at the input

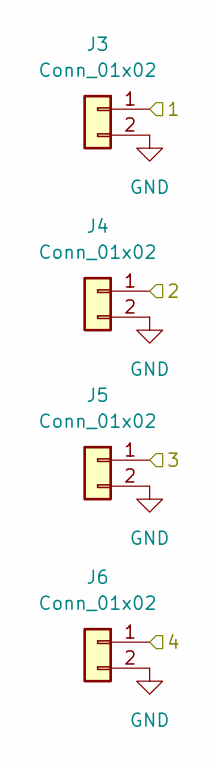
[picture p22: schematic BNCs.kicad_sch]

Parts:
J3, J4, J5, J6: Conn_01x02; 1-1337445-0

Connections:
/DAC/I_OUT: J3.1; also elsewhere on the board
/Sensing/BNCs/2: J4.1; also elsewhere on the board
/Sensing/BNCs/3: J5.1; also elsewhere on the board
/Sensing/I_In: J6.1; also elsewhere on the board
GND: J3.2, J4.2, J5.2, J6.2; also elsewhere on the board

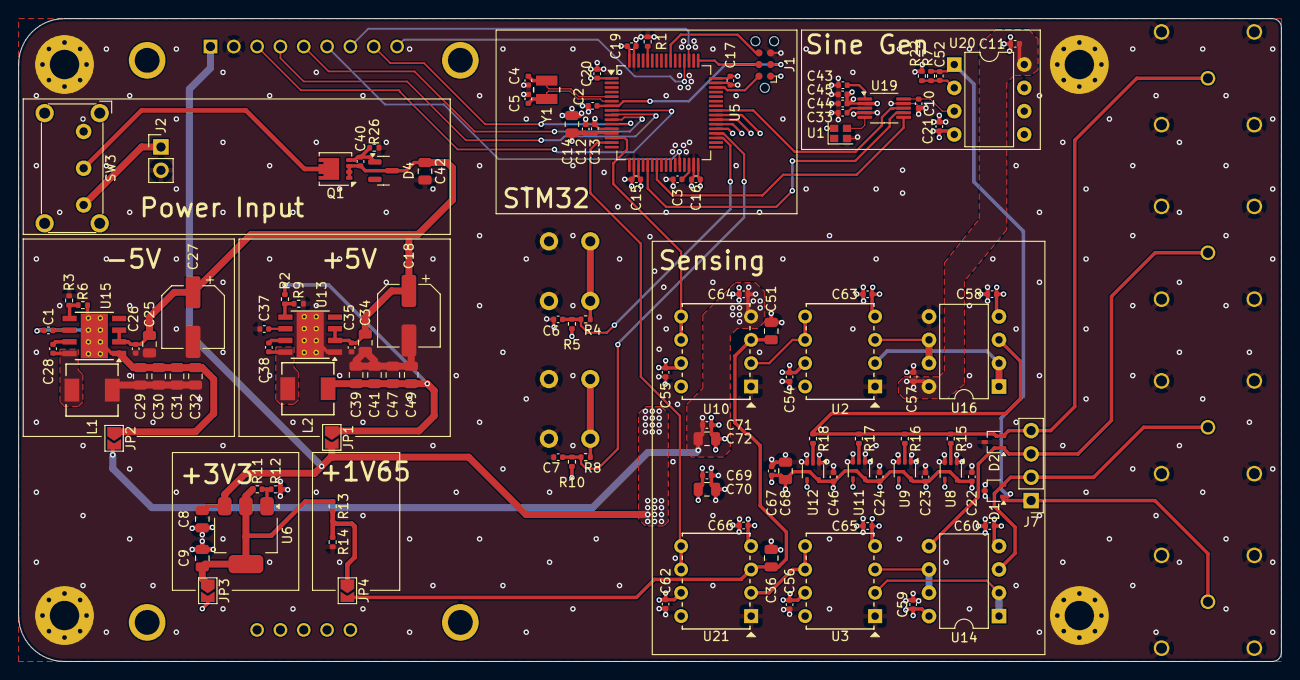
[picture p23: board lcr-meter.kicad_pcb from above]

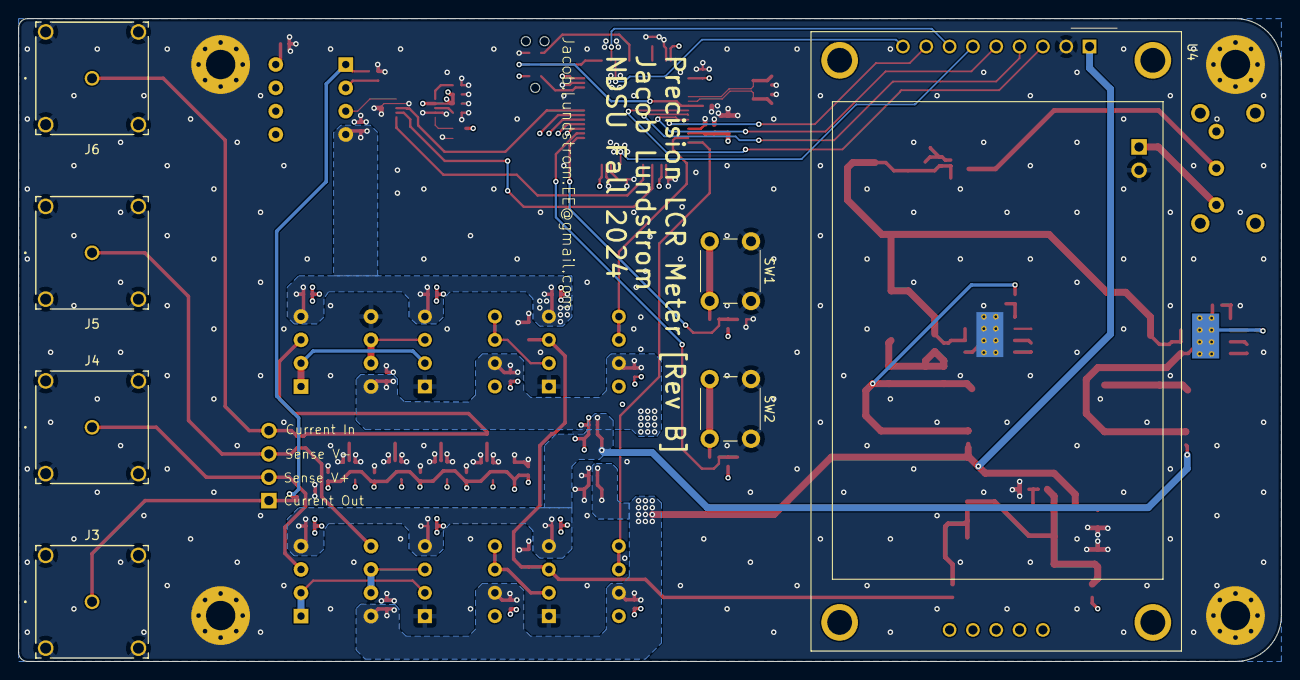
[picture p24: board lcr-meter.kicad_pcb from below]

Board: 4 copper layers, 137.5 x 70.0 mm, 131 parts (7 on the bottom side), 69 nets.
