Jacob-Lundstrom/lcr-meter-hardware/REV A Input Buffer Mod Board/REV A Input Buffer Mod Board.kicad_pcb

## KiCad design REV A Input Buffer Mod Board/REV A Input Buffer Mod Board.kicad_pcb (2024-10-28)

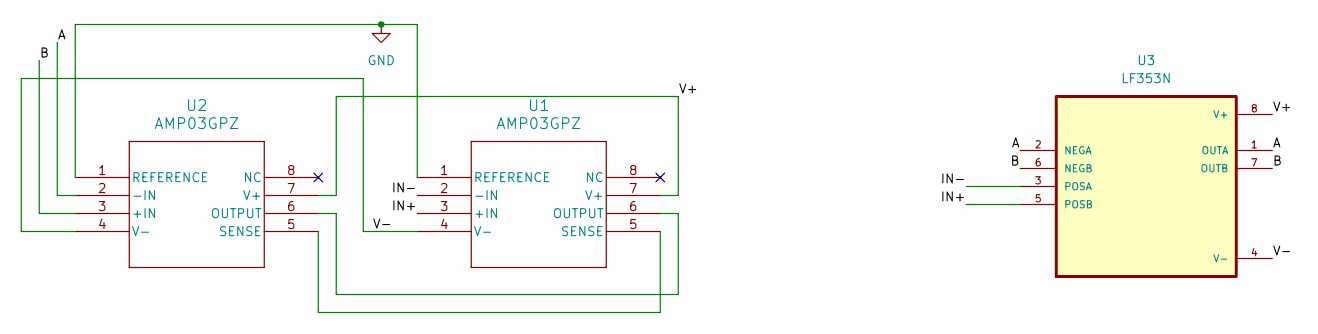
[picture p25: schematic REV A Input Buffer Mod Board.kicad_sch]

Parts:
U1, U2: AMP03GPZ; DIP-8_W7.62mm
U3: LF353N; DIP-8_W7.62mm

Connections:
/A: U2.2 (-IN), U3.1 (OUTA), U3.2 (NEGA)
/B: U2.3 (+IN), U3.6 (NEGB), U3.7 (OUTB)
/IN+: U1.3 (+IN), U3.5 (POSB)
/IN-: U1.2 (-IN), U3.3 (POSA)
/V+: U1.7 (V+), U2.7 (V+), U3.8 (V+)
/V-: U1.4 (V-), U2.4 (V-), U3.4 (V-)
GND: U1.1 (REFERENCE), U2.1 (REFERENCE)
unnamed: U1.6 (OUTPUT), U2.6 (OUTPUT)
unnamed: U1.5 (SENSE), U2.5 (SENSE)

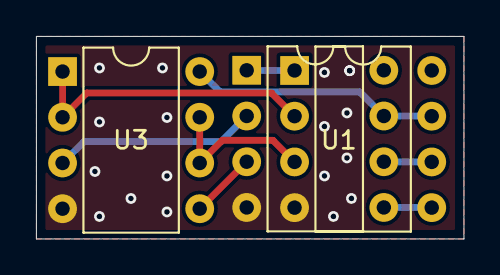
[picture p26: board REV A Input Buffer Mod Board.kicad_pcb from above]

Board: 2 copper layers, 23.8 x 11.2 mm, 3 parts (0 on the bottom side), 9 nets.
