Jacob-Lundstrom/lcr-meter-hardware/(commit log)

2024-09-09 Basic Block Diagram started
    [adc.kicad_sch, current-sensing.kicad_sch, dac.kicad_sch, lcr-meter.kicad_pcb, lcr-meter.kicad_sch, power-amplifier.kicad_sch, rpi-cm4.kicad_sch, sensing.kicad_sch]
2024-09-10 Added CM4, basics of functionality started
    [CM4IOv5-B_Cu.gbr, CM4IOv5-B_Mask.gbr, CM4IOv5-Edge_Cuts.gbr, CM4IOv5-F_Cu.gbr, CM4IOv5-F_Mask.gbr, CM4IOv5-F_Paste.gbr, CM4IOv5-F_Silkscreen.gbr, CM4IOv5-In1_Cu.gbr]
2024-09-10 Progress, removal of unnecessary components
    [CM4_GPIO.kicad_sch, CM4_HighSpeed.kicad_sch, adc.kicad_sch, dac.kicad_sch, lcr-meter.kicad_sch, rpi-cm4.kicad_sch, sensing.kicad_sch]
2024-10-06 Breadboarding notes
    [dac.kicad_sch, sensing.kicad_sch]
2024-10-13 Schematic updates, added -5V, finalized sensing
    [N_8_ADI.step, PSUs.kicad_sch, dac.kicad_sch, lcr-meter.kicad_sch, sensing.kicad_sch]
2024-10-15 Addressable LED test board
    [CM4_GPIO.kicad_sch, CM4_HighSpeed.kicad_sch, P0008A.stp, PSUs.kicad_sch, RTC.kicad_sch, USB2-HUB.kicad_sch, dac.kicad_sch, lcr-meter.kicad_sch]
2024-10-21 Schematic polishing, starting MCU schematic
    [RTC.kicad_sch, USB2-HUB.kicad_sch, adc.kicad_sch, dac.kicad_sch, lcr-meter.kicad_sch, sensing.kicad_sch, stm32f469vit.kicad_sch]
2024-10-26 Schematic completion
    [PSUs.kicad_sch, lcd.kicad_sch, lcr-meter.kicad_sch, sensing.kicad_sch, stm32f469vit.kicad_sch]
2024-10-27 Schematic polishing
    [lcd.kicad_sch, lcr-meter.kicad_sch, sensing.kicad_sch, stm32f469vit.kicad_sch]
2024-10-27 Component grouping started
    [PSUs.kicad_sch, lcr-meter.kicad_pcb, sensing.kicad_sch, stm32f469vit.kicad_sch]
2024-10-27 Component grouping completed
    [PSUs.kicad_sch, lcr-meter.kicad_pcb, lcr-meter.kicad_sch]
2024-10-28 Order submitteed, Mod board submitted
    [LF353N.step, N_8_ADI.step, PSUs.kicad_sch, REV A Input Buffer Mod Board.kicad_pcb, REV A Input Buffer Mod Board.kicad_sch, bom.csv, dac.kicad_sch, designators.csv]
2024-10-29 Rev A schematic fixes
    [lcr-meter.kicad_pcb, sensing.kicad_sch, stm32f469vit.kicad_sch]
2024-11-07 PCB updates
    [PSUs.kicad_sch, bom.csv, dac.kicad_sch, lcr-meter.kicad_pcb, lcr-meter.kicad_sch, sensing.kicad_sch]
2024-11-07 Rev B Fixes
    [BNCs.kicad_sch, REV A bom.csv, bom.csv, c-1337445-10-3-c-3d.stp, designators.csv, lcr-meter.kicad_pcb, positions.csv, sensing.kicad_sch]
2024-11-10 REV B order submitted
    [bom.csv, designators.csv, lcr-meter.kicad_pcb, lcr-meter.kicad_sch, positions.csv, stm32f469vit.kicad_sch]
2024-11-14 Added Rev B BOM
    [REV B bom.csv, bom.csv]
2024-12-29 Polishing, Poster Creation
    [dac.kicad_sch, lcr-meter.kicad_sch, sensing.kicad_sch, stm32f446re.kicad_sch]
