Jacob-Lundstrom/lcr-meter-hardware/(notices)

Notices in the files:
lcr-meter/PSUs.kicad_sch:
© 2020-2022 Raspberry Pi Ltd (formerly Raspberry Pi (Trading) Ltd.)
parts and their libraries:
Copyright 2016 Accelerated Designs. All rights reserved.
